sevinskylara/simodi/docs/img/simodi-marca-web.png

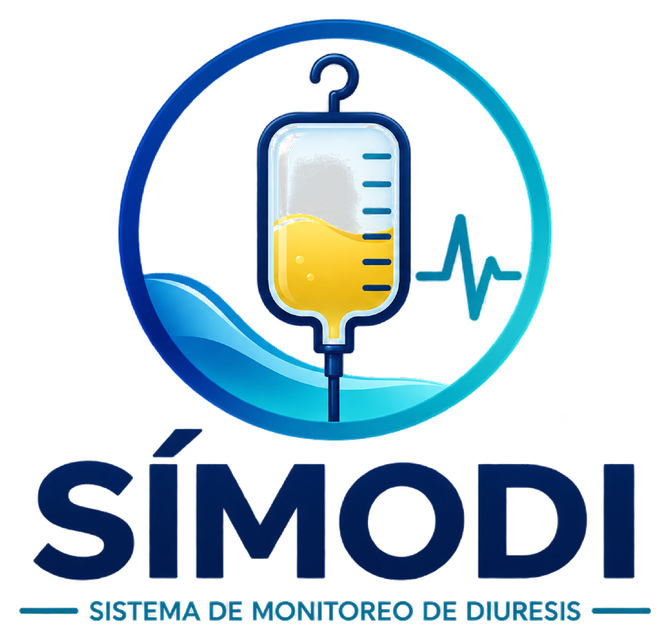
docs/img/simodi-marca-web.png
