sevinskylara/simodi/logo.pdf

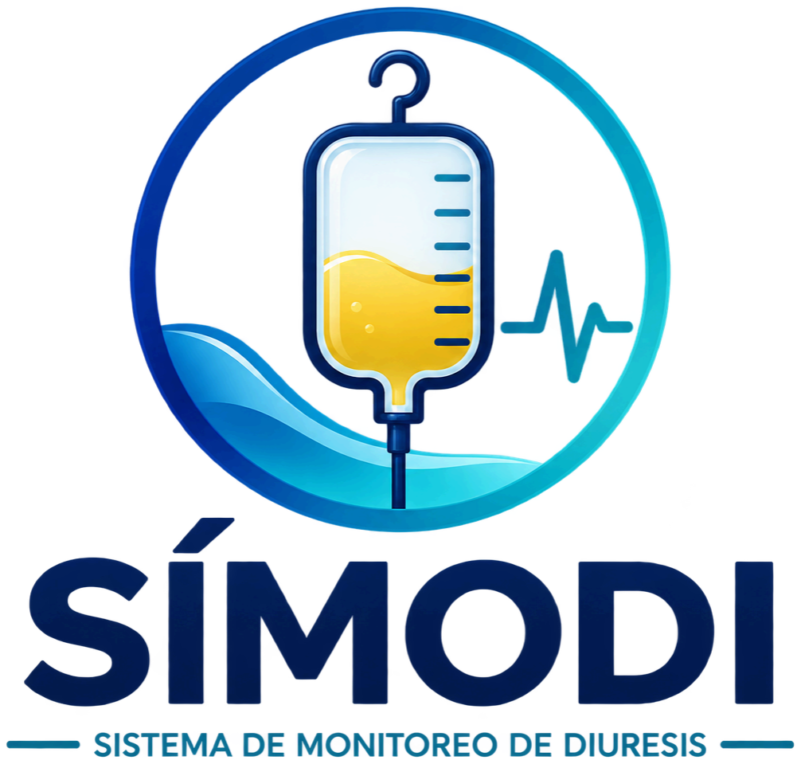
[picture p4: figure]
