sevinskylara/simodi/arduino/oled/vista_previa.png

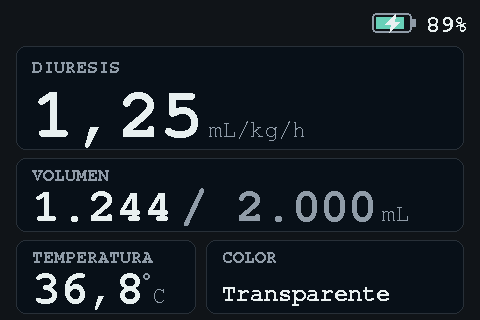
arduino/oled/vista_previa.png
