sevinskylara/simodi/arduino/oled+wifi/FreeMonoBold24pt7b.h

#pragma once

const uint8_t FreeMonoBold24pt7bBitmaps[] PROGMEM = {
    0x38, 0xFB, 0xFF, 0xFF, 0xFF, 0xFF, 0xFF, 0xFF, 0xFD, 0xF3, 0xE7, 0xCF,
    0x9F, 0x3E, 0x7C, 0xF9, 0xF3, 0xE3, 0x82, 0x00, 0x00, 0x00, 0x71, 0xF7,
    0xFF, 0xEF, 0x9E, 0x00, 0xFC, 0x7E, 0xF8, 0x7D, 0xF0, 0xFB, 0xE1, 0xF7,
    0xC3, 0xEF, 0x87, 0xDF, 0x0F, 0xBE, 0x1F, 0x38, 0x1C, 0x70, 0x38, 0xE0,
    0x71, 0xC0, 0xE3, 0x81, 0xC7, 0x03, 0x80, 0x01, 0xC1, 0xC0, 0x0F, 0x8F,
    0x80, 0x3E, 0x3E, 0x00, 0xF8, 0xF8, 0x03, 0xE3, 0xE0, 0x0F, 0x8F, 0x80,
    0x7E, 0x3E, 0x01, 0xF0, 0xF8, 0x07, 0xC7, 0xC0, 0x1F, 0x1F, 0x03, 0xFF,
    0xFF, 0x9F, 0xFF, 0xFF, 0x7F, 0xFF, 0xFD, 0xFF, 0xFF, 0xF3, 0xFF, 0xFF,
    0x81, 0xF1, 0xF0, 0x07, 0xC7, 0xC0, 0x1F, 0x1F, 0x00, 0x7C, 0x7C, 0x1F,
    0xFF, 0xFC, 0xFF, 0xFF, 0xFB, 0xFF, 0xFF, 0xEF, 0xFF, 0xFF, 0x9F, 0xFF,
    0xFC, 0x0F, 0x8F, 0x80, 0x3E, 0x3E, 0x00, 0xF8, 0xF8, 0x03, 0xE3, 0xE0,
    0x0F, 0x8F, 0x80, 0x3E, 0x3E, 0x00, 0xF8, 0xF8, 0x03, 0xE3, 0xE0, 0x0F,
    0x8F, 0x80, 0x3C, 0x3C, 0x00, 0x00, 0xE0, 0x00, 0x3E, 0x00, 0x07, 0xC0,
    0x00, 0xF8, 0x00, 0x1F, 0x00, 0x1F, 0xFF, 0x07, 0xFF, 0xF1, 0xFF, 0xFE,
    0x7F, 0xFF, 0xDF, 0xC1, 0xFB, 0xF0, 0x1F, 0x7C, 0x01, 0xEF, 0x80, 0x39,
    0xF8, 0x00, 0x3F, 0xF8, 0x03, 0xFF, 0xE0, 0x3F, 0xFF, 0x03, 0xFF, 0xF0,
    0x0F, 0xFF, 0x00, 0x1F, 0xE0, 0x00, 0x7F, 0xC0, 0x07, 0xF8, 0x00, 0xFF,
    0x80, 0x1F, 0xF8, 0x07, 0xFF, 0x81, 0xFB, 0xFF, 0xFF, 0x7F, 0xFF, 0xCF,
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
    {2362, 25, 27, 28, 1, -26},  // 0x46 'F'
    {2447, 25, 29, 28, 2, -27},  // 0x47 'G'
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

const GFXfont FreeMonoBold24pt7b PROGMEM = {
    (uint8_t *)FreeMonoBold24pt7bBitmaps, (GFXglyph *)FreeMonoBold24pt7bGlyphs,
    0x20, 0x7E, 47};

// Approx. 7469 bytes
