sevinskylara/simodi/arduino/oled+wifi/FreeMonoBold36pt7b.h

#pragma once
const uint8_t FreeMonoBold36pt7bBitmaps[] PROGMEM = {
  0x00, 0x1F, 0x0F, 0xF9, 0xFF, 0x7F, 0xFF, 0xFF, 0xFF, 0xFF, 0xFF, 0xFF,
  0xFF, 0xFF, 0xFF, 0xFF, 0xFF, 0xF7, 0xFC, 0xFF, 0x9F, 0xF3, 0xFE, 0x7F,
  0xCF, 0xF9, 0xFF, 0x3F, 0xE7, 0xFC, 0xFF, 0x8F, 0xE1, 0xFC, 0x3F, 0x87,
  0xF0, 0xFE, 0x1F, 0xC3, 0xF8, 0x7F, 0x07, 0xC0, 0xF8, 0x00, 0x00, 0x00,
  0x00, 0x00, 0x00, 0x00, 0x3E, 0x1F, 0xE3, 0xFE, 0xFF, 0xDF, 0xFF, 0xFF,
  0x3F, 0xE7, 0xFC, 0x3E, 0x00, 0xFF, 0x03, 0xFF, 0xFC, 0x0F, 0xFF, 0xF0,
  0x3F, 0xFF, 0xC0, 0xFF, 0xFF, 0x03, 0xFF, 0xFC, 0x0F, 0xFF, 0xE0, 0x3F,
  0x9F, 0x80, 0x7E, 0x7E, 0x01, 0xF9, 0xF8, 0x07, 0xE7, 0xE0, 0x1F, 0x9F,
  0x80, 0x7E, 0x7E, 0x01, 0xF9, 0xF8, 0x07, 0xE7, 0xC0, 0x1F, 0x0F, 0x00,
  0x3C, 0x3C, 0x00, 0xF0, 0xF0, 0x03, 0xC3, 0xC0, 0x0F, 0x0F, 0x00, 0x3C,
  0x18, 0x00, 0x60, 0x00, 0x3C, 0x03, 0x80, 0x00, 0x7E, 0x07, 0xC0, 0x00,
  0x7E, 0x0F, 0xE0, 0x00, 0xFE, 0x0F, 0xE0, 0x00, 0xFE, 0x0F, 0xE0, 0x00,
  0xFE, 0x0F, 0xE0, 0x00, 0xFE, 0x0F, 0xE0, 0x00, 0xFE, 0x0F, 0xE0, 0x00,
  0xFE, 0x0F, 0xE0, 0x00, 0xFE, 0x0F, 0xE0, 0x00, 0xFE, 0x0F, 0xE0, 0x00,
  0xFE, 0x0F, 0xE0, 0x00, 0xFE, 0x0F, 0xE0, 0x00, 0xFE, 0x0F, 0xE0, 0x00,
  0xFE, 0x0F, 0xE0, 0x01, 0xFE, 0x0F, 0xE0, 0x1F, 0xFF, 0xFF, 0xFE, 0x7F,
  0xFF, 0xFF, 0xFF, 0x7F, 0xFF, 0xFF, 0xFF, 0x7F, 0xFF, 0xFF, 0xFF, 0x7F,
  0xFF, 0xFF, 0xFF, 0x7F, 0xFF, 0xFF, 0xFF, 0x1F, 0xFF, 0xFF, 0xFE, 0x01,
  0xFC, 0x1F, 0xC0, 0x01, 0xFC, 0x1F, 0xC0, 0x01, 0xFC, 0x1F, 0xC0, 0x01,
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
  {  5341,  37,  41,  43,    2,  -40 },   // 0x46 'F'
  {  5531,  40,  43,  43,    2,  -41 },   // 0x47 'G'
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

const GFXfont FreeMonoBold36pt7b PROGMEM = {
  (uint8_t  *)FreeMonoBold36pt7bBitmaps,
  (GFXglyph *)FreeMonoBold36pt7bGlyphs,
  0x20, 0x7E, 71 };

// Approx. 15987 bytes
