sevinskylara/simodi/(commit log)

2026-08-28 Central SÍMODI: mural multi-cama, modo piloto y enlace real con ESP32
    Central de enfermería para el monitor de diuresis (peso, temperatura y
    color de orina). Incluye mural de camas con KPIs y alertas KDIGO, modo
    piloto con escenarios clínicos simulados, modo real con enlace WiFi/BLE/USB
    al ESP32 y búfer ante cortes de señal, gráficos propios en canvas, y
    persistencia en localStorage.
2026-08-28 Renombra central/ a docs/ para poder publicar con GitHub Pages
    GitHub Pages solo permite servir desde la raíz del repo o desde una
    carpeta llamada exactamente docs/, así que se renombra la carpeta de
    la app (sin cambios funcionales) y se actualizan las rutas del README.
2026-08-28 Suma identidad de operador y sincronización compartida con Firestore
    - Nuevo js/operador.js: pregunta quién opera cada computadora (local,
    no se sincroniza) y permite cambiarlo desde el chip de la barra o
    desde Configuración.
    - Los eventos de auditoría quedan sellados con el operador que hizo el
    cambio (asignar paciente, liberar cama, vaciado manual, cambio de
    modo/escenario); los eventos automáticos (alertas, enlace) quedan
    como "Sistema".
    - Nuevo js/nube.js: sincroniza pacientes, camas y el registro de
    eventos en tiempo real vía Firebase Firestore, con caché offline.
    Las muestras de sensor siguen siendo locales a cada navegador.
    Inerte hasta completar FIREBASE_CONFIG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
2026-08-28 Activa la base de datos compartida (Firebase Firestore)
    Se completa FIREBASE_CONFIG con los datos del proyecto simodi-9b9f9.
    Probado con dos navegadores independientes: un paciente creado en uno
    aparece en tiempo real en el otro sin recargar.
2026-08-28 Reemplaza el KPI de diuresis media por camas en objetivo
    Promediar mL/kg/h entre pacientes de peso y objetivo distintos no es
    un dato clínico interpretable. Se muestra en cambio cuántas camas
    están dentro de rango vs. total con datos (ej. 3/6), que sí resume
    el estado de la sala de un vistazo.
2026-08-28 Agrega debounce al motor de alarmas para evitar el parpadeo
    Una lectura ruidosa aislada (temperatura o color justo en el límite de
    un umbral) podía disparar y resolver la misma alerta en cada muestra,
    generando docenas de eventos duplicados y repitiendo el sonido de
    alarma cada pocos segundos. Ahora una condición tiene que sostenerse
    6 segundos (2 muestras) antes de confirmarse o de darse por resuelta.
    Probado: 12 alternancias sin tiempo real entre medio no confirman
    ninguna alerta ni generan eventos (ruido correctamente descartado);
    las alertas sostenidas de la sala de ejemplo se confirman una sola
    vez cada una, sin duplicados.
2026-08-28 Corrige eventos duplicados por el eco de la base compartida
    Cada evento se guardaba con un id local y, al sincronizarse con
    Firestore, la escritura generaba un id nuevo ahí. Cuando ese mismo
    evento volvía por el listener en tiempo real, no había forma de
    reconocerlo como "ya lo tengo" y se agregaba de nuevo — resultando en
    cada alerta y cada resolución duplicadas en el registro.
    Ahora el id se genera localmente al crear el evento y se usa ese mismo
    id como id del documento en Firestore, así el eco se descarta por
    Modelo.aplicarEventoRemoto en lugar de duplicarse.
    Probado de forma aislada: crear un evento y simular su rebote con el
    mismo id no lo duplica en Modelo.estado.eventos.
2026-08-28 Suma re-alerta: una alerta reconocida vuelve a sonar si persiste
    Hasta ahora, reconocer una alerta la silenciaba para siempre mientras
    no empeorara ni se resolviera del todo — si el mismo problema seguía
    igual de mal horas después, nadie se enteraba. Ahora cada nivel tiene
    una ventana de gracia (15 min crítica, 30 alta, 60 media, 120 técnica);
    pasado ese tiempo sin resolverse, la alerta se reabre sola y vuelve a
    sonar, y queda anotado "Persiste: ..." en el registro con cuánto hace
    que se había reconocido.
    Probado: reconocer una alerta y simular que venció su ventana de
    gracia la reabre (reconocida=false) y genera el evento "Persiste".
2026-08-31 Create auth.js
    Agrega modulo de autenticacion
2026-08-31 Carga modulo de autenticacion
2026-08-31 Agrega pantalla de inicio de sesion
2026-08-31 Agrega estilos para login
2026-08-31 Hace que SIMODI inicie despues del login
2026-08-31 Completa autenticacion de usuarios
2026-09-01 Ajustes visuales y de datos en la vista de tendencias del paciente
    Gráficos:
    - Agrega la línea de umbral de poliuria (3 mL/kg/h) al gráfico de
    diuresis horaria, junto a la de oliguria ya existente, para que la
    franja normal quede delimitada por ambos extremos.
    - Corrige el estirado/pixelado de los gráficos al abrir la ficha de
    un paciente: abrirDetalle() dibujaba los <canvas> antes de que el
    modal (display:none -> flex) fuera visible, así que Graf.preparar()
    medía ancho 0 y caía al tamaño por defecto (320px), que después se
    estiraba por CSS al ancho real del modal.
    - Corrige que las cajas Temp./Color/Acumulado tuvieran alto variable
    entre pacientes y que nombres de col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
2026-09-01 Silenciar alarmas, trasladar pacientes y mejoras al panel de alertas
    Silenciar/posponer alertas (nuevo):
    - Cada alerta activa suma un botón "Silenciar" que pregunta si el
    paciente ya fue atendido o sigue en espera, y reprograma cuándo
    puede volver a sonar según el nivel de gravedad y esa respuesta
    (Alertas.silenciar, Acciones.silenciarAlerta). Ventanas basadas en
    las definiciones horarias de KDIGO y en la recomendación de
    controlar la diuresis al menos cada 3 h (KDIGO 2012 AKI Guideline).
    - No está disponible para "Invitado": hace falta un operador con
    nombre cargado, si no se avisa por toast y no se abre el diálogo.
    - Cada vez que se silencia una alerta queda un evento en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
2026-09-01 Alinea el mural con el panel lateral y pule las animaciones de alerta
    Mural de camas → flex en vez de grid:
    - .mural pasa de grid con columnas de ancho fijo a flex-wrap, para que
    la última fila (cuando queda incompleta) reparta el ancho sobrante
    entre sus propias tarjetas en vez de dejarlas angostas con un hueco
    vacío a la derecha (grid reservaba columnas de ancho fijo para toda
    la grilla, no fila por fila).
    Alto del panel lateral atado al mural, no a un porcentaje fijo:
    - "Alertas activas" iguala su alto al de las dos primeras filas de
    camas (borde superior con borde superior, borde inferior de la 2.ª
    fila con borde inferior del panel) en vez del viejo max-height:60vh
    fi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
2026-09-01 Corrige crash de renderizado y prolija el mural, filtros y ficha de cama
    Bugs:
    - tarjetaCama() rompía con TypeError si cama.dispositivoId no resolvía a
    un dispositivo local (dato sincronizado desde otra compu: dispositivos
    y muestras son locales a cada navegador, no viajan por Firestore). La
    excepción abortaba a mitad el forEach de pintarMural(), por eso "Orden
    por criticidad/cama" mostraba menos camas que "Por diuresis": en
    realidad no eran filtros, era el render cortándose en un punto distinto
    según el orden. claseEstado() ahora agrupa ese caso bajo "sindispositivo"
    en vez de "sinsenal", y esa tarjeta ya no asume que el dispositivo existe.
    - Alto del panel lateral (igual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
2026-09-01 Empareja botón +Cama con los filtros y hace expandible el registro de eventos
    - "+ Cama" perdió el modificador "chico": quedaba visiblemente más bajo
    que los <select> de filtro/orden de al lado; ahora comparte el alto
    base de .btn.secundario.
    - Glow rojo propio en #btnCerrarSesion:hover (antes usaba el mismo teal
    genérico de .ico-btn, sin distinguir que es la acción de cerrar sesión).
    - "Registro de eventos" ahora se puede expandir: hover en cualquier parte
    del panel prende un glow (con inset, para no recortarse contra el
    overflow:hidden del panel) sólo en la caja del título, y un click ahí
    la expande a ~70% del alto de ventana mostrando hasta 300 eventos (vs.
    40 en mo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
2026-09-01 Alinea el borde de la fila incompleta del mural con la fila de arriba
    .cama tenía max-width:780px fijo para que la tarjeta huérfana de una
    fila incompleta creciera en vez de dejar un hueco vacío, pero era sólo
    una aproximación a "2 columnas": no coincidía exactamente con el ancho
    real de columna en cada resolución, así que el borde quedaba pisado o
    corto según el ancho de pantalla.
    alinearAnchoFilaIncompleta() mide, después de cada repintado del mural,
    el ancho real de una tarjeta en una fila completa y fija --ancho-doble
    (2 columnas + el gap) como max-width real; 780px queda sólo de fallback
    para el primer render. Verificado con 4 camas arriba + 1 huérfana abajo:
    el borde derec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
2026-09-02 Desprolija el mural y la ficha de cama, y agrega la fuente de alimentación del dispositivo
    - Mural: saca edad/peso/HC, umbral y acumulado de la tarjeta; el número
    principal pasa a ser mL/kg/h y las etiquetas Temp./Color se sacan
    (el dato ya es autoexplicativo). "Bolsa colectora" se acorta a "Bolsa".
    - Ficha de cama: agrega el estado de enlace ("Transmitiendo"/"Sin señal")
    con indicador en la solapa, un rayo en el ícono de batería cuando el
    dispositivo está conectado, y el nuevo campo "Fuente" (batería / toma
    eléctrica) de punta a punta (modelo, simulador y parser del enlace real).
    - Detalle: saca la tarjeta numérica "Volumen acumulado" (ya está el
    gráfico) y hace que e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
2026-09-02 Corrige crash del modal de asignar cuando el dispositivo es de otra estación
    Con la base compartida activa, una cama puede tener un dispositivoId
    que apunta a un equipo que sólo existe en el navegador de otra
    computadora (por ejemplo un piloto de prueba creado en otra estación).
    Al abrir "Asignar"/"Reasignar" sobre esa cama, el modal intentaba leer
    datos de ese dispositivo inexistente localmente y tiraba una excepción
    a mitad de la función — por eso ni la lista de dispositivos ni el
    botón Guardar llegaban a armarse (y de paso tampoco daba de alta al
    paciente, porque es el mismo modal).
    Ahora, si el dispositivo asignado no existe en este navegador, se
    omite de la lista en lugar de ro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
2026-09-02 +Cama rellena el primer número libre en vez de saltar al final
    Antes, borrar una cama y agregar otra nunca reutilizaba ese número:
    "+Cama" siempre arrancaba a contar desde el total de camas existentes,
    así que borrar la UTI-03 y agregar una nueva daba una UTI-09 en vez de
    recuperar la UTI-03. Ahora busca el primer número libre desde el 1,
    que es como se espera que se comporten las camas físicas de una sala.
    Probado: borrar A3 y agregar una cama nueva vuelve a darle el id A3 /
    etiqueta UTI-03.
2026-09-02 Agranda los 5 KPI de la cabecera
    Las tarjetas de resumen (camas ocupadas, en objetivo, en riesgo,
    alertas, sin señal) quedaban chicas frente al mural de camas de abajo.
    Se agrandan los números (26px → 38px) y el padding de las tarjetas, y
    se pareja el ancho de las 5 (antes la última quedaba fija en 320px
    mientras las otras cuatro se achicaban).
2026-09-02 Avisa cuando 12h/24h muestran lo mismo por falta de historial
    No era un bug de los gráficos: si un dispositivo lleva, por ejemplo,
    8 h transmitiendo, las ventanas de 12 h y 24 h terminan mostrando
    exactamente los mismos datos porque no hay más historial guardado
    todavía. Ahora se avisa "Solo hay X h de historial en este equipo"
    junto a los botones de rango cuando pasa esto, para que no parezca
    un error.
    Reproducido: con un dispositivo de 8 h de historial, el aviso no
    aparece en 6 h (hay datos de sobra) pero sí en 12 h y 24 h, con el
    mismo texto en ambos — el mismo patrón reportado.
2026-09-03 Corrige error de sintaxis en alertas.js que rompía toda la app
    Los últimos commits de "Modificación colores orina" habían borrado el
    return out; y el cierre de la función reglas() al simplificar la regla
    de color a las nuevas categorías (rojizo/marrón). Al faltar ese cierre,
    alertas.js no compilaba y la página quedaba sin arrancar en absoluto
    (afectaba a la versión publicada en GitHub Pages).
    Verificado: los 13 archivos JS pasan el chequeo de sintaxis y la app
    carga sin errores con el nuevo esquema de colores funcionando.
2026-09-03 Corrige etiquetas de hora cortadas y superpuestas en los gráficos
    Las etiquetas de los extremos se centraban sobre su marca y el límite
    que las mantenía dentro del lienzo era muy chico para el ancho real
    del texto, así que la primera y la última quedaban recortadas contra
    el borde (ej. "07:10 a. m." se veía como ":10 a. m."). Ahora la
    primera se alinea a la izquierda y la última a la derecha, ancladas
    exactamente al borde del gráfico.
    De paso, en gráficos angostos (Temperatura y Color en el tiempo, que
    comparten la mitad del ancho) pedir 5 marcas de tiempo hacía que las
    etiquetas se superpusieran entre sí y se volvieran ilegibles. Ahora se
    mide el ancho real del texto con ctx.mea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
2026-09-03 El hover del gráfico de color responde por hora, no por tramo entero
    Como las muestras se agrupan en tramos por categoría para pintar la
    tira, el hover heredaba esas mismas zonas: si toda la ventana era del
    mismo color había un solo tramo, así que mover el cursor mostraba
    siempre el mismo dato fijo ("Desde 07:23 a. m.") en vez de responder
    por hora como el resto de los gráficos.
    Se separa el agrupamiento en tramos (que sigue siendo por color, solo
    para pintar los rectángulos) de las zonas de hover (que ahora son por
    muestra individual, igual que en los demás gráficos), así el cursor
    recorre las horas reales aunque el color no haya cambiado.
    Probado: simulando el mouse en 5 puntos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
2026-09-03 El gráfico de diuresis siempre ocupa el rango completo (6/12/24 h)
    Antes, Modelo.bucketsHorarios() omitía directamente las horas
    anteriores al historial real del dispositivo, así que si un equipo
    llevaba, por ejemplo, 5 h transmitiendo, pedir la vista de 24 h
    terminaba mostrando solo 5 barras estiradas para ocupar todo el
    ancho del gráfico — el eje de tiempo no correspondía a las horas
    reales elegidas.
    Ahora bucketsHorarios() siempre devuelve exactamente la cantidad de
    casilleros pedida (6, 12 o 24), marcando con sinDatos:true los que
    caen antes del historial real. Graf.barrasDiuresis() no dibuja barra
    en esos casilleros (el espacio queda vacío en su posición correcta de
    la grilla,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
2026-09-08 Saca la fila de KPIs de la cabecera
    Se quita la sección de 5 tarjetas resumen (camas ocupadas, en
    objetivo, en riesgo, alertas activas, sin señal) para simplificar la
    pantalla principal: la sección en index.html, la función que la
    dibujaba (UI.pintarKpis) y su llamada en pintarTodo(), y el CSS
    correspondiente.
2026-09-08 Saca el chip de operador y los indicadores de conexión de la barra
    Ahora que entrar exige loguearse (Firebase Auth), preguntar aparte
    "¿quién sos?" es redundante — operador.js pasa a leer directamente la
    identidad de la cuenta logueada (firebase.auth().currentUser) para el
    registro de auditoría, en vez de guardar un nombre tipeado a mano en
    localStorage. Se elimina el chip para cambiar de operador, el modal
    de "¿Quién está operando esta computadora?" y la sección "Usuario de
    esta computadora" en Configuración.
    De paso desaparece el concepto de "Invitado": como ya no se puede
    entrar sin loguearse, no hace falta bloquear silenciar alarmas por
    falta de nombre — se saca esa guarda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
2026-10-07 Create Arduino
